DeanJ87/SQMeter-hardware/hardware/labels/sqmeter-label-enclosure-70x24mm-600dpi.png

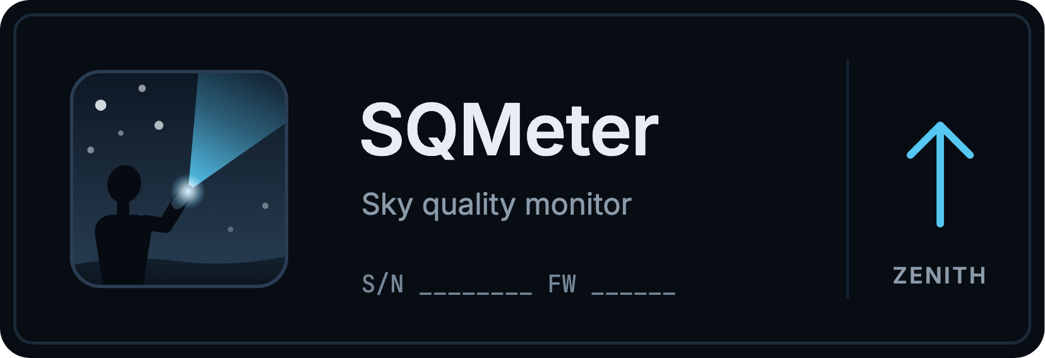
hardware/labels/sqmeter-label-enclosure-70x24mm-600dpi.png
