DeanJ87/SQMeter-hardware/hardware/labels/sqmeter-label-enclosure-mono-600dpi.png

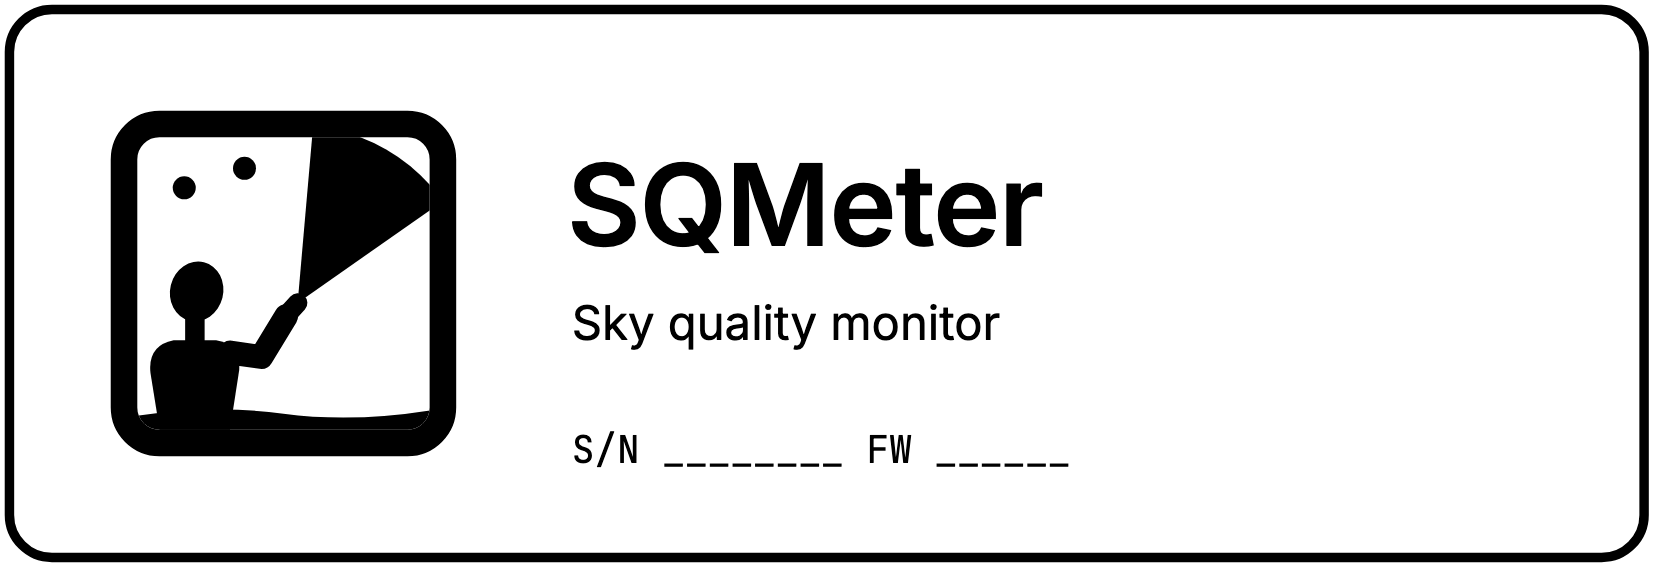
hardware/labels/sqmeter-label-enclosure-mono-600dpi.png
