DeanJ87/SQMeter-hardware/hardware/manufacturing/SQMeter-Hardware-Travel-revA/SQMeter-Hardware-Travel-revA-bom.csv

Comment | Designator | Footprint | LCSC Part #
10u 25V | C14,C15,C16 | C_0805_2012Metric | C15850
100n | C21,C22 | C_0603_1608Metric | C14663
SS34 | D3 | D_SMA | C8678
USB-C 5V | J2 | USB_C_Receptacle_HRO_TYPE-C-31-M-12 | C165948
I2C TSL2591 #1 | J3 | JST_XH_B4B-XH-A_1x04_P2.50mm_Vertical | C144395
I2C MLX90614 | J4 | JST_XH_B4B-XH-A_1x04_P2.50mm_Vertical | C144395
I2C BME280 | J5 | JST_XH_B4B-XH-A_1x04_P2.50mm_Vertical | C144395
I2C OLED | J6 | JST_XH_B4B-XH-A_1x04_P2.50mm_Vertical | C144395
GPS | J7 | JST_XH_B4B-XH-A_1x04_P2.50mm_Vertical | C144395
AUX | J10 | JST_XH_B4B-XH-A_1x04_P2.50mm_Vertical | C144395
Zero left | J11 | PinSocket_1x09_P2.54mm_Vertical | C22438159
Zero right | J12 | PinSocket_1x09_P2.54mm_Vertical | C22438159
I2C-2 TSL2591 #2 | J13 | JST_XH_B4B-XH-A_1x04_P2.50mm_Vertical | C144395
BATTERY | J21 | JST_PH_B2B-PH-K_1x02_P2.00mm_Vertical | C131337
AO3400A | Q2,Q3 | SOT-23 | C20917
5.1k | R2,R3 | R_0603_1608Metric | C23186
4.7k | R7,R8,R20,R21 | R_0603_1608Metric | C23162
100 | R9,R10,R33 | R_0603_1608Metric | C22775
270k | R24 | R_0603_1608Metric | C22965
100k | R25 | R_0603_1608Metric | C25803
1.2k | R26 | R_0603_1608Metric | C22765
10k | R27,R28,R29,R30,R35 | R_0603_1608Metric | C25804
1k | R34 | R_0603_1608Metric | C21190
0 | R36 | R_0603_1608Metric | C21189
POWER | SW3 | SW_SPDT_Shouhan_MSK12C02 | C431540
10k B3380 | TH1 | R_0603_1608Metric | C13564
USBLC6-2SC6 | U4,U7 | SOT-23-6 | C7519
MCP73871-2CA | U8 | QFN-20-1EP_4x4mm_P0.5mm_EP2.5x2.5mm_ThermalVias | C185603
DW01A | U10 | SOT-23-6 | C351410
MAX17048 | U11 | TDFN-8-1EP_2x2mm_P0.5mm_EP0.8x1.2mm | C2682616
