DeanJ87/SQMeter-hardware/hardware/manufacturing/SQMeter-Hardware-revA/SQMeter-Hardware-revA-bom.csv

Comment | Designator | Footprint | LCSC Part #
100u 35V | C1 | CP_Elec_8x10 | C165636
10u 25V | C2,C3 | C_0805_2012Metric | C15850
100n | C4,C8,C10,C11 | C_0603_1608Metric | C14663
22u | C5,C6 | C_0805_2012Metric | C45783
10u | C7 | C_0805_2012Metric | C15850
1u | C9 | C_0603_1608Metric | C15849
SMBJ18CA | D1 | D_SMB | C78413
SS34 | D3 | D_SMA | C8678
STATUS | D4 | LED_0603_1608Metric | C12624
1.5A 24V | F1 | Fuse_1812_4532Metric | C32404
0.5A 24V | F2 | Fuse_1206_3216Metric | C492011
12V IN | J1 | PhoenixContact_MSTBA_2,5_2-G-5,08_1x02_P5.08mm_Horizontal | C3697
USB-C | J2 | USB_C_Receptacle_HRO_TYPE-C-31-M-12 | C165948
I2C TSL2591 #1 | J3 | JST_XH_B4B-XH-A_1x04_P2.50mm_Vertical | C144395
I2C MLX90614 | J4 | JST_XH_B4B-XH-A_1x04_P2.50mm_Vertical | C144395
I2C BME280 | J5 | JST_XH_B4B-XH-A_1x04_P2.50mm_Vertical | C144395
I2C SPARE | J6 | JST_XH_B4B-XH-A_1x04_P2.50mm_Vertical | C144395
GPS | J7 | JST_XH_B4B-XH-A_1x04_P2.50mm_Vertical | C144395
RG-15 | J8 | PhoenixContact_MC_1,5_4-G-3.5_1x04_P3.50mm_Horizontal | C5188297
WIND | J9 | PhoenixContact_MC_1,5_5-G-3.5_1x05_P3.50mm_Horizontal | C5188298
AUX | J10 | JST_XH_B4B-XH-A_1x04_P2.50mm_Vertical | C144395
I2C-2 TSL2591 #2 | J13 | JST_XH_B4B-XH-A_1x04_P2.50mm_Vertical | C144395
4.7u 3.3A | L1 | L_Sunlord_SWPA6045S | C78804
AO3401A | Q1 | SOT-23 | C15127
10k | R1,R4,R5,R13,R15,R19 | R_0603_1608Metric | C25804
5.1k | R2,R3 | R_0603_1608Metric | C23186
1k | R6,R14,R16 | R_0603_1608Metric | C21190
4.7k | R7,R8,R20,R21 | R_0603_1608Metric | C23162
100 | R9,R10,R11,R12 | R_0603_1608Metric | C22775
RESET | SW1 | SW_Push_1P1T_XKB_TS-1187A | C318884
BOOT | SW2 | SW_Push_1P1T_XKB_TS-1187A | C318884
AP63203WU | U1 | TSOT-23-6 | C780769
USBLC6-2SC6 | U2,U4,U5,U6,U7 | SOT-23-6 | C7519
ESP32-S3-WROOM-1-N16R8 | U3 | ESP32-S3-WROOM-1 | C2913202
