DeanJ87/SQMeter-hardware/CHANGELOG.md

# Changelog

All notable hardware revisions will be documented here.

Hardware versions are tied to physical board revisions and are independent of firmware versions.

---

## [Unreleased]

- Initial KiCad project setup
- Schematic and PCB layout in progress

---

<!-- Template for future entries:

## [v0.1.0] - YYYY-MM-DD

### Added
- Initial schematic
- Initial PCB layout
- First gerber export

### Changed
-

### Fixed
-

-->
