DeanJ87/SQMeter-hardware/hardware/labels/sqmeter-sticker-round-60mm.pdf

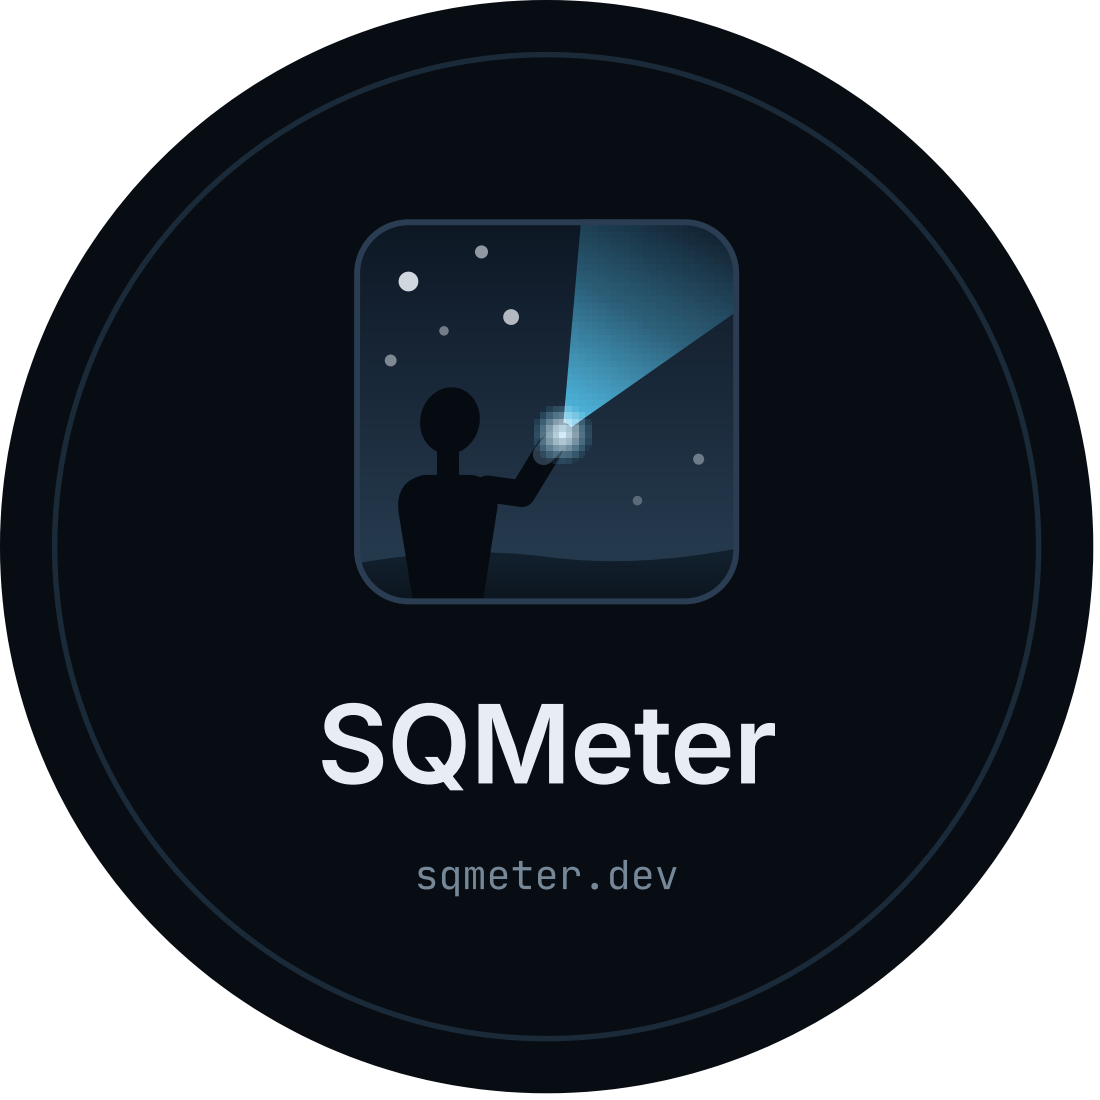
[picture p3: page 1]
SQMeter; sqmeter.dev
