DeanJ87/SQMeter-hardware/hardware/kicad/SQMeter-Hardware-Zero.kicad_pcb

## KiCad design hardware/kicad/SQMeter-Hardware-Zero.kicad_pcb (2026-10-16)

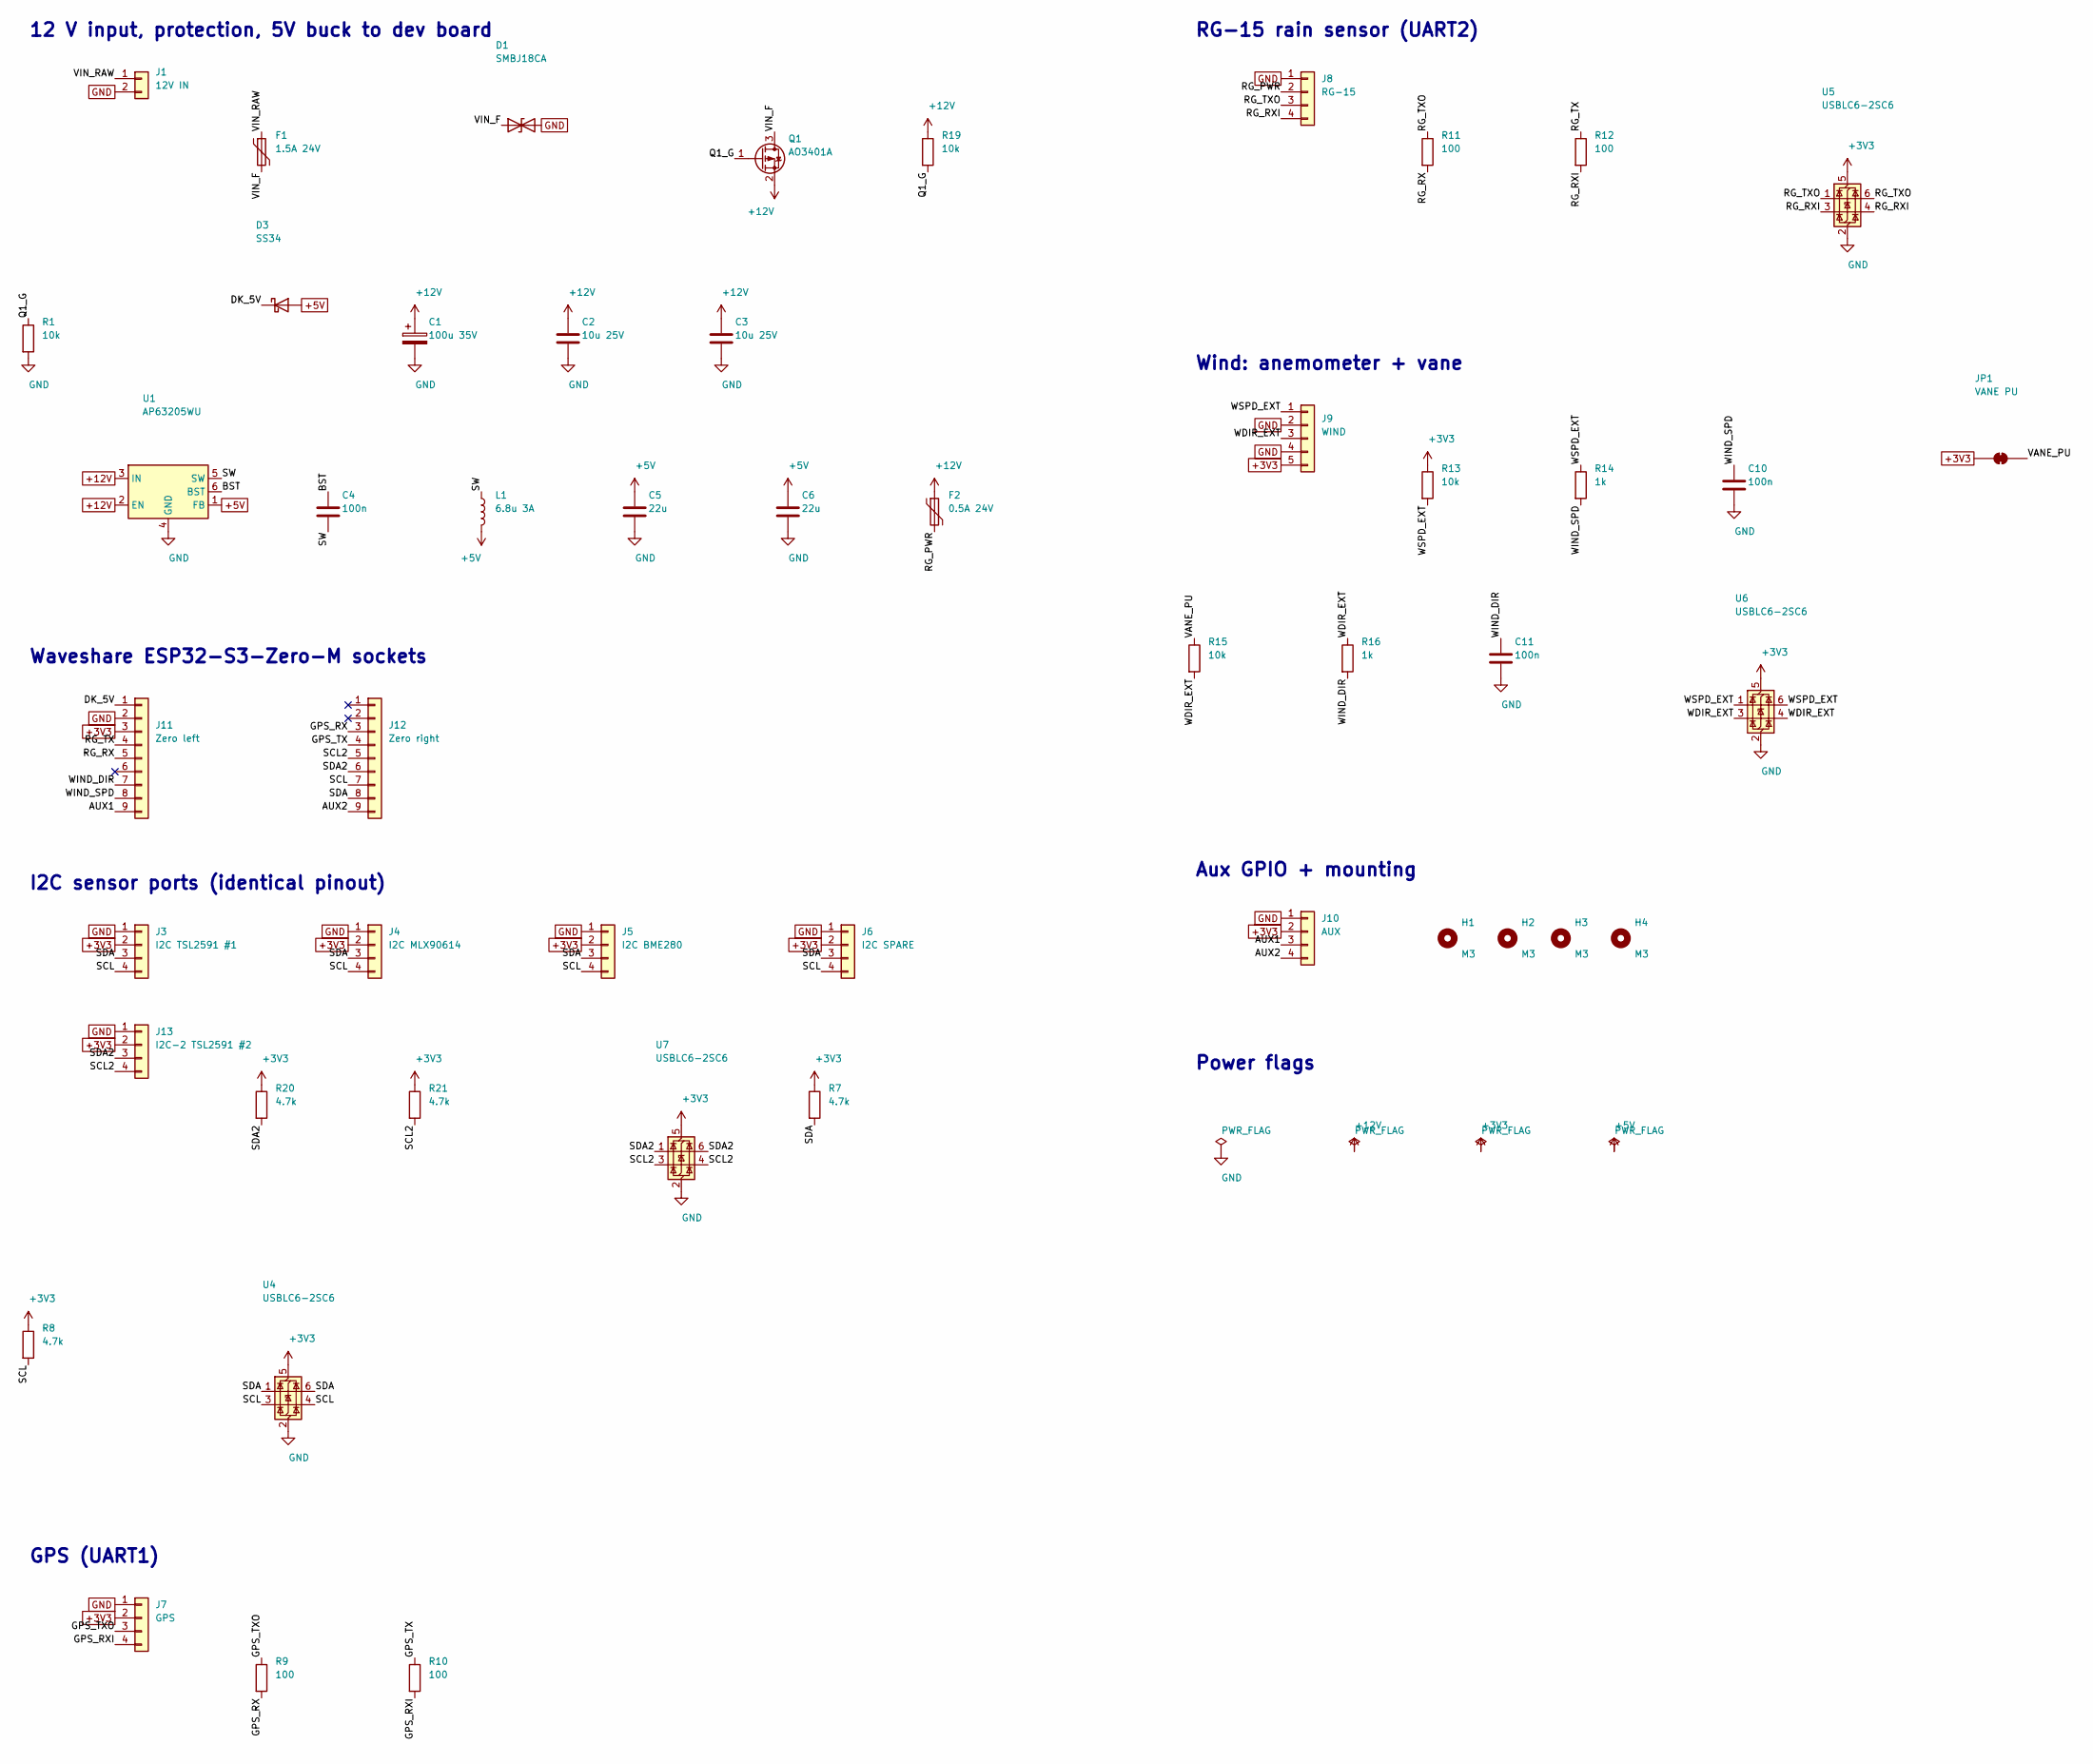
[picture p4: schematic SQMeter-Hardware-Zero.kicad_sch, SQMeter main board]

Parts:
C1: 100u 35V; CP_Elec_8x10; LCSC C165636
C2, C3: 10u 25V; C_0805_2012Metric; LCSC C15850
C4, C10, C11: 100n; C_0603_1608Metric; LCSC C14663
C5, C6: 22u; C_0805_2012Metric; LCSC C45783
D1: SMBJ18CA; D_SMB; LCSC C78413
D3: SS34; D_SMA; LCSC C8678
F1: 1.5A 24V; Fuse_1812_4532Metric; LCSC C32404
F2: 0.5A 24V; Fuse_1206_3216Metric; LCSC C492011
H1, H2, H3, H4: M3; MountingHole_3.2mm_M3
J1: 12V IN; PhoenixContact_MSTBA_2,5_2-G-5,08_1x02_P5.08mm_Horizontal; LCSC C3697
J3: I2C TSL2591 #1; JST_XH_B4B-XH-A_1x04_P2.50mm_Vertical; LCSC C144395
J4: I2C MLX90614; JST_XH_B4B-XH-A_1x04_P2.50mm_Vertical; LCSC C144395
J5: I2C BME280; JST_XH_B4B-XH-A_1x04_P2.50mm_Vertical; LCSC C144395
J6: I2C SPARE; JST_XH_B4B-XH-A_1x04_P2.50mm_Vertical; LCSC C144395
J7: GPS; JST_XH_B4B-XH-A_1x04_P2.50mm_Vertical; LCSC C144395
J8: RG-15; PhoenixContact_MC_1,5_4-G-3.5_1x04_P3.50mm_Horizontal; LCSC C5188297
J9: WIND; PhoenixContact_MC_1,5_5-G-3.5_1x05_P3.50mm_Horizontal; LCSC C5188298
J10: AUX; JST_XH_B4B-XH-A_1x04_P2.50mm_Vertical; LCSC C144395
J11: Zero left; PinSocket_1x09_P2.54mm_Vertical; LCSC C22438159
J12: Zero right; PinSocket_1x09_P2.54mm_Vertical; LCSC C22438159
J13: I2C-2 TSL2591 #2; JST_XH_B4B-XH-A_1x04_P2.50mm_Vertical; LCSC C144395
JP1: VANE PU; SolderJumper-2_P1.3mm_Bridged_RoundedPad1.0x1.5mm
L1: 6.8u 3A; L_Sunlord_SWPA6045S; LCSC C57254
Q1: AO3401A; SOT-23; LCSC C15127
R1, R13, R15, R19: 10k; R_0603_1608Metric; LCSC C25804
R7, R8, R20, R21: 4.7k; R_0603_1608Metric; LCSC C23162
R9, R10, R11, R12: 100; R_0603_1608Metric; LCSC C22775
R14, R16: 1k; R_0603_1608Metric; LCSC C21190
U1: AP63205WU; TSOT-23-6; LCSC C2071056
U4, U5, U6, U7: USBLC6-2SC6; SOT-23-6; LCSC C7519

Connections:
+3V3: J3.2, J4.2, J5.2, J6.2, J7.2, J9.5, J10.2, J11.3, J13.2, JP1.1 (A), R7.1, R8.1, R13.1, R20.1, R21.1, U4.5 (VBUS), U5.5 (VBUS), U6.5 (VBUS), U7.5 (VBUS)
+5V: C5.1, C6.1, D3.2 (A), L1.2, U1.1 (FB)
+12V: C1.1, C2.1, C3.1, F2.1, Q1.2 (S), R19.1, U1.2 (EN), U1.3 (IN)
/AUX1: J10.3, J11.9
/AUX2: J10.4, J12.9
/BST: C4.1, U1.6 (BST)
/DK_5V: D3.1 (K), J11.1
/GPS_RX: J12.3, R9.2
/GPS_RXI: J7.4, R10.2
/GPS_TX: J12.4, R10.1
/GPS_TXO: J7.3, R9.1
/Q1_G: Q1.1 (G), R1.1, R19.2
/RG_PWR: F2.2, J8.2
/RG_RX: J11.5, R11.2
/RG_RXI: J8.4, R12.2, U5.3 (I/O2), U5.4 (I/O2)
/RG_TX: J11.4, R12.1
/RG_TXO: J8.3, R11.1, U5.1 (I/O1), U5.6 (I/O1)
/SCL: J3.4, J4.4, J5.4, J6.4, J12.7, R8.2, U4.3 (I/O2), U4.4 (I/O2)
/SCL2: J12.5, J13.4, R21.2, U7.3 (I/O2), U7.4 (I/O2)
/SDA: J3.3, J4.3, J5.3, J6.3, J12.8, R7.2, U4.1 (I/O1), U4.6 (I/O1)
/SDA2: J12.6, J13.3, R20.2, U7.1 (I/O1), U7.6 (I/O1)
/SW: C4.2, L1.1, U1.5 (SW)
/VANE_PU: JP1.2 (B), R15.1
/VIN_F: D1.1 (A1), F1.2, Q1.3 (D)
/VIN_RAW: F1.1, J1.1
/WDIR_EXT: J9.3, R15.2, R16.1, U6.3 (I/O2), U6.4 (I/O2)
/WIND_DIR: C11.1, J11.7, R16.2
/WIND_SPD: C10.1, J11.8, R14.2
/WSPD_EXT: J9.1, R13.2, R14.1, U6.1 (I/O1), U6.6 (I/O1)
GND: C1.2, C2.2, C3.2, C5.2, C6.2, C10.2, C11.2, D1.2 (A2), J1.2, J3.1, J4.1, J5.1, J6.1, J7.1, J8.1, J9.2, J9.4, J10.1, J11.2, J13.1, R1.2, U1.4 (GND), U4.2 (GND), U5.2 (GND), U6.2 (GND), U7.2 (GND)

Notes on the sheet:
12 V input, protection, 5V buck to dev board
Waveshare ESP32-S3-Zero-M sockets
I2C sensor ports (identical pinout)
GPS (UART1)
RG-15 rain sensor (UART2)
Wind: anemometer + vane
Aux GPIO + mounting
Power flags

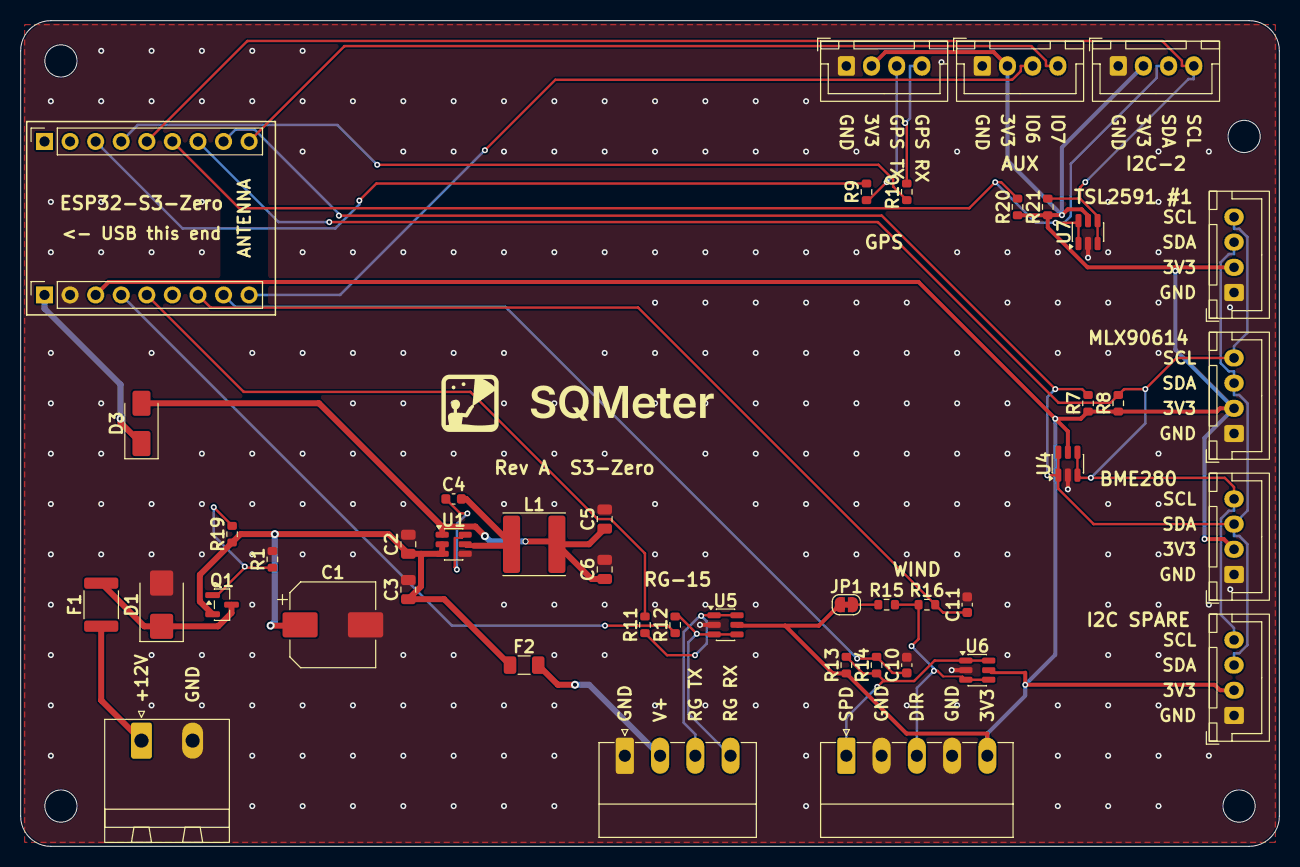
[picture p5: board SQMeter-Hardware-Zero.kicad_pcb from above]

Board: 2 copper layers, 125.0 x 82.0 mm, 50 parts (0 on the bottom side), 30 nets.
