DeanJ87/SQMeter-hardware/(commit log)

2026-04-26 chore: initial repository scaffold
    Directory structure, docs, scripts, and CI workflows for the SQMeter
    hardware repo. KiCad project files not yet included — scaffold only.
2026-10-13 Add print-ready SQMeter labels, sticker and physical marks (#2)
2026-10-16 feat: main board v1 (ESP32-S3) schematic, placement and autorouted layout
    ESP32-S3-WROOM-1 with native USB-C, protected 12 V input, AP63203 buck,
    identical JST-XH I2C ports (GND/3V3/SDA/SCL), pluggable terminals for
    power, RG-15 and wind, ESD on external lines. Generated from
    hardware/generator; ERC clean, DRC clean (bar edge-connector silk).
2026-10-16 feat: DevKitC-1 socket variant, verified LCSC parts, JLC fab exports
    - SQM_VARIANT=devkit swaps the soldered module for ESP32-S3-DevKitC-1 sockets
    (header geometry from Espressif's DXF), 5 V buck feeding the DevKit 5V pin,
    antenna keepout and silkscreen outline
    - every part has an in-stock LCSC number; polyfuses moved to 24 V parts
    - export_jlc.sh writes gerber zip, BOM and CPL per variant
    - build retries routing until DRC has no unconnected or dangling items
2026-10-16 feat: Waveshare ESP32-S3-Zero socket variant and one GPIO map for all boards
    - SQM_VARIANT=zero: ESP32-S3-Zero-M on 2x9 sockets (Waveshare pinout and
    drawing), same 5 V feed scheme as the DevKit variant
    - GPIO map unified across module, DevKit and Zero (limited by the Zero's
    GPIO1-13 headers): RG-15 1/2, wind 4/5, I2C 8/9, GPS 12/13, AUX 6/7/10/11
    - fab exports for all three
2026-10-16 fix: centre boards on the A4 sheet instead of hanging off the page origin
2026-10-16 feat: second I2C bus for a second TSL2591 (SQM + SQM-L)
    TSL2591 has a fixed address, so the second sensor gets its own bus on
    GPIO10/11 (I2C-2 JST-XH port, own pull-ups and ESD). AUX drops to IO6/IO7.
    Q1 gate zener replaced by a resistor divider (one fewer extended part).
2026-10-16 feat: brand lockup on silkscreen, hardware Rev A, JLC-ready gerber zips
    - SQMeter lockup (brand kit silkscreen mark + Inter SemiBold name) as plain
    silkscreen polygons from brand_silk.json; no font install needed
    - HW_REV = A: on the silkscreen, KiCad title blocks, gerber metadata and fab
    file names; versioned separately from firmware
    - drop the verbose I2C pinout line; per-pin labels already cover it
    - gerber zip holds only fab layers + drill files
2026-10-16 feat: Inter Bold silkscreen (embedded), black mask / white silk stackup
    - all silkscreen text and references in Inter Bold, min 1.2 mm; font embedded in
    the board files so they open the same without Inter installed
    - stroke widths measured on plotted gerbers (>0.15 mm); KiCad's TrueType
    thickness check ignored as it flags every size of the variable font
    - stackup: black solder mask, white silkscreen (3D view; colour is picked at order)
2026-10-16 feat: ESP32-S3-ETH PoE home board and Li-ion travel board
    - eth: Waveshare ESP32-S3-ETH (+ PoE module) on 2x20 sockets, PoE or 12 V in,
    MT3608 boost keeps the RG-15 at 12.6 V on PoE; own GPIO map (W5500 owns 9-14)
    - travel: ESP32-S3-Zero, USB-C only, MCP73871 power-path Li-ion charger with
    NTC cold-charge cut-off, power slide switch, battery/charger status on GPIO,
    OLED port; 85 x 66 mm, no field wiring
    - connector titles placed relative to their connector so layouts can differ
2026-10-16 feat(travel): 1S2P 18650 support, fuel gauge and cell protection
    - MCP73871 in adapter mode, 833 mA charge, safety timer off (7 Ah pack)
    - MAX17048 fuel gauge on I2C (0x36): SoC %, voltage, charge/discharge rate;
    ALRT on GPIO1 (replaces the ADC divider)
    - DW01A + 2x AO3400A low-side protection for bare cells
    - thermal-via QFN for the charger; project symbol library for the MAX17048
